matt1795/elex7660-project/README.md

SPI to Composite Video Encoder
==============================
A project by Cole Harkness and Matthew Knight
