matt1795/elex7660-project/report/main.tex

\documentclass{article}

% Packages
\usepackage{amsmath}
\usepackage[top=1.2in, right=0.75in, left=0.75in, bottom=0.75in, 
	    headheight=41pt]{geometry}
\usepackage{graphicx}
\usepackage{circuitikz}
\usepackage{fancyhdr}
\usepackage{lastpage}
\usepackage{setspace}
\usepackage{tabularx}
\usepackage[yyyymmdd]{datetime}
\usepackage{listings}
\usepackage{float}
\usepackage{cite}

% Style settings
\graphicspath{{images/}}
\setlength{\parindent}{0pt}
\setlength{\parskip}{1em}
\renewcommand{\familydefault}{\sfdefault}
\renewcommand{\headrulewidth}{0pt}
\renewcommand{\dateseparator}{--}
\setcounter{secnumdepth}{0}

% Title Page
\title{	ELEX 7660: Digital System Design \\
	Composite Video Encoder with SPI Interface}
\author{Matthew Knight, Cole Harkness}
\date{\today}

% kk let's actually begin the document now
\begin{document}

\clearpage
\maketitle
    \thispagestyle{empty}

\newpage

\tableofcontents

\newpage

\input{introduction}
\input{background}
\input{objectives}
\input{implementation}
\input{results}
\input{conclusion}
\newpage

%\addcontentsline{toc}{section}{References}
\bibliographystyle{ieeetr}
\bibliography{sample}

\newpage
\input{appendices}

\end{document}
