matt1795/elex7660-project/report/proposal.tex

\documentclass{article}

% Packages
\usepackage{amsmath}
\usepackage[top=1.2in, right=0.75in, left=0.75in, bottom=0.75in, 
	    headheight=41pt]{geometry}
\usepackage{graphicx}
\usepackage{circuitikz}
\usepackage{fancyhdr}
\usepackage{lastpage}
\usepackage{setspace}
\usepackage{tabularx}
\usepackage[yyyymmdd]{datetime}
\usepackage{listings}
\usepackage{float}

% Style settings
\graphicspath{{images/}}
\setlength{\parindent}{0pt}
\setlength{\parskip}{1em}
\renewcommand{\familydefault}{\sfdefault}
\renewcommand{\headrulewidth}{0pt}
\renewcommand{\dateseparator}{--}

% Title Page
\title{	ELEX 7660: Digital System Design \\
	Composite Video Encoder with SPI Interface Proposal}
\author{Matthew Knight, Cole Harkness}
\date{\today}

% kk let's actually begin the document now
\begin{document}

\clearpage
\maketitle
    \thispagestyle{empty}

\newpage
\input{introduction}
\input{objectives}
\newpage
\input{partslist}
\input{Milestones}

\newpage
\input{Schedule}

\end{document}
