matt1795/elex7660-project/report/Schedule.tex

\subsubsection*{Schedule}

\begin{enumerate}
	\item February 14
	\begin{enumerate}
		\item Submitting the proposal
	\end{enumerate}
	\item February 17
	\begin{enumerate}
		\item Project meeting to plan and divide work 
	\end{enumerate}
	\item February 24
	\begin{enumerate}
		\item Progress report
	\end{enumerate}
	\item March 3
	\begin{enumerate}
		\item Testing our basic Verilog test bench code
		\item Testing our CTR TV with our digital to analog converter and basic test bench code
		\item Progress report and analysis on current progress.
	\end{enumerate}
	\item March 10
	\begin{enumerate}
		\item Testing our improved test bench code
		\item Testing our CTR TV with our improved test bench code
		\item Progress report and proposed solutions to bugs
	\end{enumerate}
	\item March 24
	\begin{enumerate}
		\item Confirm our CRT TV works with in black and white
		\item Connect and test SPI input using Pong Game from MSP430
		\item Progress report and proposed solutions to bugs
	\end{enumerate}
	\item March 31
	\begin{enumerate}
		\item Confirm our CRT TV works with in black and white and colour.
		\item Confirm the SPI input works 
		\item Progress report and proposed solutions to bugs
		\item Test other groups NES system (if available) for compatibility 
	\end{enumerate}
	\item April 7
	\begin{enumerate}
		\item Confirm and demonstrate our CRT TV works with in black and white and colour.
		\item Confirm and demonstrate the SPI input works with pong game and NES system 
		\item Party if the project works according to schedule
	\end{enumerate}
\end{enumerate}
