matt1795/elex7660-project/report/appendices.tex

\section{Appendix}

\subsection{Module Listings}

\lstinputlisting[language=Verilog]{../source/compositeDriver.v}
\lstinputlisting[language=Verilog]{../source/SPI_LOWRES.v}
\lstinputlisting[language=Verilog]{../source/videoGen.v}
\lstinputlisting[language=Verilog]{../source/timer.v}
\lstinputlisting[language=Verilog]{../source/blockfifo.v}
\lstinputlisting[language=Verilog]{../source/colourDecoder.v}
\lstinputlisting[language=Verilog]{../source/nco.v}
\lstinputlisting[language=Verilog]{../source/lut.v}
\lstinputlisting[language=Verilog]{../source/delay.v}
