matt1795/elex7660-project/(commit log)

2017-03-02 SPI Module so fasr
    I DONT KNOW WHAT TO SAYY
2017-03-03 Measured Conposite video and added some documentation
    [oneLine.csv, syncAndBurst.csv]
2017-03-04 Compiled SPI File
    Don't know how to compile with the 50Mhz clock but we shall figure that
    out.
2017-03-07 Fixed synthesizer wiring bugs
    [synthesizer.v]
2017-03-08 Fixed signed signals in synthesizer, video now synthesizes correctly for the colour decoder
    [colourDecoder.v, synthesizer.v]
2017-03-10 Added colour burst signals to the colour palette. Started on a timer module
2017-03-20 Started control module
    Final product will include a timer module
    Frame control
    Address control
    SDRAM control module
    Basically this is a start for using the SDRAM and controlling the
    addresses.
    I know How to impliment this to include individual pixel changing.
    So i throughly thought this through.
    Also i changed the SPI module so it will convert the 8 bit input and
    store the data on a 16 bit buffer so it would make easy conversons for
    the SDRAM.
2017-03-21 New work on project
    [Adc_Module.sch]
2017-03-25 Here are some finished modules
    MATT I THINK I FINISHED
    Also its easy to add things to the frame controller and SPI to add
    communications.
2017-04-03 SPI tested
2017-04-06 Added timer module
2017-04-17 DAC board added and untouched secondary objectives removed
